krutikdg/GestureCar/BOM.csv

Component | Quantity | Price/Unit (USD) | Purpose | Purchase Link
ESP32 dev board, 38 pin | 2 | 3.65 | car and handheld brain | https://www.electropi.in/esp32-development-board-with-wifi-bluetooth-india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
Ai thinker BU03 kit UWB board | 4 | 34.90 | 3 car anchors and 1 handheld tag for follow me | https://robosap.in/product/ai-thinker-bu03-kit-development-board-uwb-module/
USB cables | 1 | 6.40 | flashing configuring and charging | https://www.flipkart.com/portronics-usb-type-c-cable-3-1-m-konnect-b/p/itm520c0fac46ed5?pid=ACCGKZNAK7DUYE7Z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
header pins | 1 | 0.31 | mounting boards and modules | https://probots.co.in/40-x-1-male-header-pins-long.html
geared DC motor 6V TT style | 4 | 5.60 | wheel drive for the 4WD car | https://robu.in/product/n20-6v-65rpm-metal-gear-motor-with-encoder-d-type/
wheel 65mm | 4 | 1.70 | drive wheels | https://robu.in/product/65mm-robot-smart-car-12-rim-wheel-silver/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
TB6612FNG dual motor driver module | 2 | 1.70 | one driver per side | https://www.flyrobo.in/tb6612fng-dual-motor-driver-module-1a-for-arduino-micro-controller?tracking=ads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
VL53L1X ToF distance sensor module | 1 | 6.20 | front obstacle sensing and auto brake | https://robu.in/product/gy-53-vl53l0x-laser-tof-flight-time-ranging-sensor-module-serial-port-pwm-output/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
HC SR04 ultrasonic sensor | 1 | 2.0 | rear obstacle sensing while reversing | https://www.amazon.in/Robocraze-Ultrasonic-Non-Contact-Resolution-Automation/dp/B01I1ZTPJC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
WS2812B LED strip 5V | 1 | 2.70 | underglow. about 10 pixels fit the plate recess, so a 60 LEDs per metre strip cut to 17 cm is enough | https://www.amazon.in/InLightss-Ws2812b-Flexible-Individual-Addressable/dp/B0CXVKBRM8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
74AHCT125 level shifter IC | 1 | 26.15 | clean 5V data signal for the LED strip from a 3.3V pin | https://www.amazon.in/TQDLYKHS-SN74AHCT125N-MM74ACT125N-MC74ACT125N-MC74ACT125NG/dp/B0CKV2Q71Z
18650 Li-ion cell | 2 | 0.50 | car battery | https://quartzcomponents.com/products/18650-li-ion-rechargeable-battery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
2S 18650 battery holder | 1 | 1 | holds the two car cells | https://www.amazon.in/Electro-Electron-18650-Battery-Holder/dp/B0GJ61WB5H
2S BMS board with balancing | 1 | 1 | car battery protection and balancing | https://www.flyrobo.in/2s-10a-8.4v-li-ion-battery-protection-board-with-balance?tracking=ads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
2S 18650 charger | 1 | 1.55 | Charges the car cells. | https://techdelivers.com/18650-dual-battery-fast-charger-5volt-1amp
Buck converter 6V motor rail | 1 | 2.50 | Regulated motor supply | https://robu.in/product/dc-dc-5-40v-to-6v-1a-buck-converter-module/
Buck converter 5V logic rail 5A | 1 | 1.25 | separate supply for the ESP32 3 UWB anchors sensors and LED strip | https://robocraze.com/products/5a-dc-to-dc-cc-cv-lithium-battery-step-down-charging-board-led-power-converter-lithium-charger-step-down-module-xl4015-red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
Rocker switch 21 x 15 mm rated for motor current | 1 | 0.25 | car power on/off | https://roboticsdna.in/product/black-rocker-switch-on-off-on-3-pin-21x15mm-dpdt-kcd1-6a-250vac-10a-125vac/
inline fuse holder and 5A fuse | 1 | 1.65 | protects the car battery line from shorts | https://www.amazon.in/Ovicart-6-35x25mm-Fuse-5A-Glass/dp/B09YHLYWBZ
electrolytic capacitor 1000 uF 16V | 2 | 0.087 | motor rail and LED strip smoothing | https://www.ktron.in/product/16v-1000uf-electrolytic-capacitor-keltron/
ceramic capacitor 100 nF | 1 | 2.45 | across motor terminals to reduce noise and the handheld battery divider | https://kitsguru.com/products/100nf-50v-monolithic-ceramic-capacitor-104-100pcs
JST connector set | 1 | 2.07 | battery and rail connections | https://www.amazon.in/Electronic-Spices-Connection-Installation-Electronics/dp/B07NBV19QQ
screw terminal blocks (pack) | 1 | 0.90 | motor and power wiring | https://zbotic.in/product/4-pin-2-54mm-pitch-pluggable-screw-terminal-block-pack-of-3/
MPU6050 IMU module | 1 | 2 | handheld tilt sensing | https://techdelivers.com/mpu-6050-gy-521-6-axis-accelerometer-gyroscope-module-i2c-interface-motion-tracking-arduino-compatible-robotics-sensor-embedded-system
SSD1306 0.96 inch OLED I2C | 1 | 1.78 | handheld status display | https://robocraze.com/products/0-96in-oled-display-module-4pin?variant=40192586645657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
tactile push buttons 6 x 6 mm (pack) | 1 | 2 | arm and mode buttons | https://www.amazon.in/ElectroBot-Momentary-Tactile-Push-Button/dp/B07PRRRBRY
RGB LED 5mm common cathode | 1 | 0.45 | handheld status LED | https://robocraze.com/products/5mm-common-anode-rgb-led-4pin-pack-of-10?variant=45740181946592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
coin vibration motor 3V 10 mm | 1 | 0.85 | haptic feedback | https://robu.in/product/erm-coin-vibration-motor-d10mm-w-3-4mm/
NPN transistor BC547 (pack) | 1 | 0.15 | switches the vibration motor | https://robocraze.com/products/bc547-transistor-ic-pack-of-5?variant=40192360448153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
diode 1N4148 (pack) | 1 | 0.40 | flyback protection for the vibration motor | https://robocraze.com/products/1n4148-diode-pack-of-10?variant=40194274263193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
1S LiPo pouch cell 703450 class (about 7 x 34 x 50 mm) 1500 to 1800 mAh with protection board and JST-PH 2.0 plug | 1 | 49 | Handheld battery. Check the plug polarity with a multimeter before connecting | https://www.amazon.in/EEMB-Rechargeable-Connector-Wireless-Polarity/dp/B09DPL8RZH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
TP4056 charging module with protection | 1 | 0.60 | charges the handheld battery | https://electroglobal.in/store/tp4056-charging-module-battery-protection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
5V boost converter module 1S input 2A or more | 1 | 1.30 | steps the handheld battery up to 5V for the ESP32 and BU03 tag | https://robu.in/product/ip5310-5v-3a-type-c-boost-power-module/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
slide switch about 8 x 4 x 4 mm | 1 | 0.35 | handheld power on/off | https://shokitech.com/product/spdt-slide-switch-pack-of-5-for-electronic-projects/
resistor assortment | 1 | 2.40 | dividers LED resistors transistor base and the HC SR04 echo divider | amazon.in/JukrTM-Assorted-Carbon-Resistors-Package/dp/B081LJTFW5
perf board about 70 x 50 mm for the car and a small one for the handheld | 2 | 0.45 | one for the car and one for the handheld | https://rajivelectronics.com/product/70-x-50-mm-double-side-2-54-mm-pitch-general-purpose-dotted-pcb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
silicone hookup wire | 1 | 0.30 | general wiring | https://robu.in/product/high-quality-ultra-flexible-22awg-silicone-wire-1000m-black/
heat shrink tubing assortment | 1 | 1.75 | insulating joints | https://www.amazon.in/Rpi-shop-Polyolefin-Insulated-Multicolour/dp/B08S3TP2Q6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
double sided foam tape and cable ties | 1 | 0.40 | holds the LiPo vibration motor and loose wiring | https://www.zepto.com/pn/thyone-ty-tp23-1pcs-double-sided-foam-tape-3-meter-length-24-mm-width/pvid/954c6ee8-4868-46e8-a52e-0dd70d01cc2a
M3 screws nuts and standoffs kit | 1 | 15.16 | chassis and deck mounting | amazon.in/350PCS-M3-Female-Standoff-Assortment/dp/B0BXT71WJK?source=ps-sl-shoppingads-lpcontext&ref_=fplfs&psc=1&smid=A1YZ9MMK17G6RH
M3 heat set inserts and M3 screws 8 to 10 mm | 1 | 1.10 | six deck posts on the car chassis | https://robu.in/product/m3-x-8-mm-brass-heat-set-threaded-round-insert-nut-25-pcs/
PLA filament 1 kg | 1 | 13.90 | chassis deck and handheld enclosure printing | https://ideal3d.in/products/esun-pla-filament-white
