krutikdg/GestureCar/CAD/car/GestureCar_Chassis_BODY.step

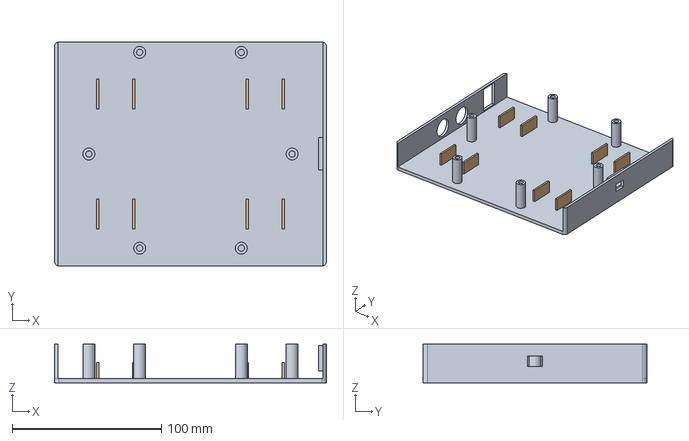
[picture p1: CAD file, 2026-11-11]
CAD/car/GestureCar_Chassis_BODY.step
182.0 x 150.0 x 26.0 mm
