krutikdg/GestureCar/CAD/handheld/GestureCar_Handheld.step

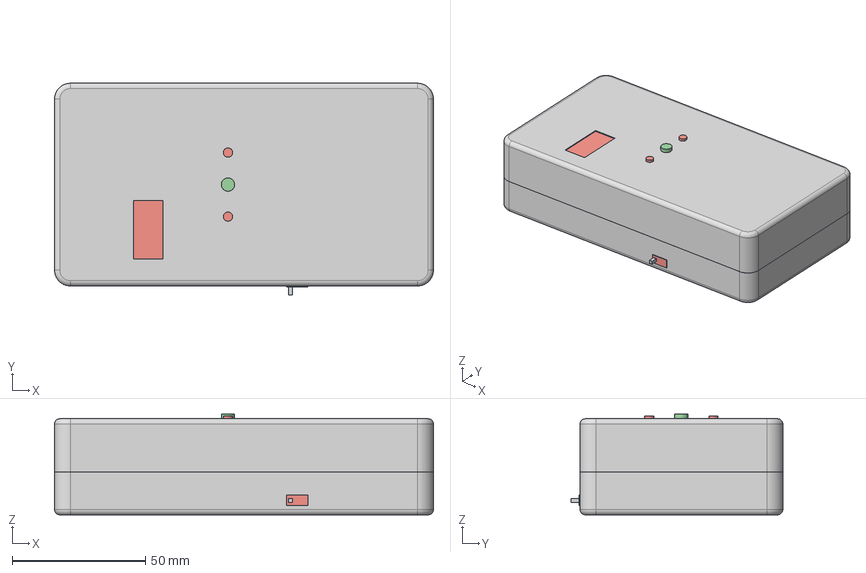
[picture p2: CAD file, 2026-11-11]
CAD/handheld/GestureCar_Handheld.step
142.0 x 79.3 x 37.7 mm
