krutikdg/GestureCar/CAD/car/GestureCar_Chassis.step

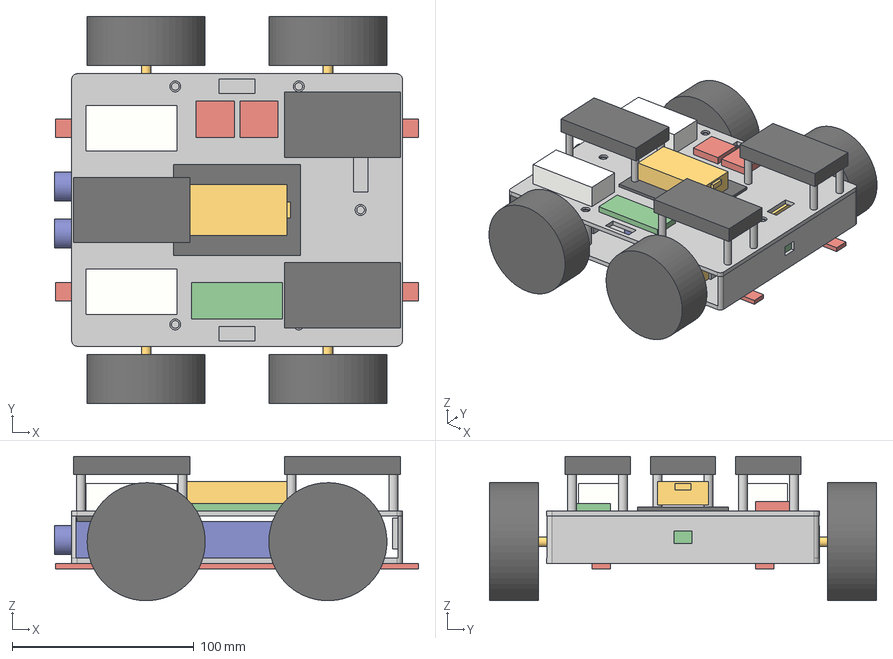
[picture p3: CAD file, 2026-11-11]
CAD/car/GestureCar_Chassis.step
200.6 x 213.0 x 79.5 mm
