krutikdg/GestureCar/CAD/handheld/GestureCar_Handheld_COVER.step

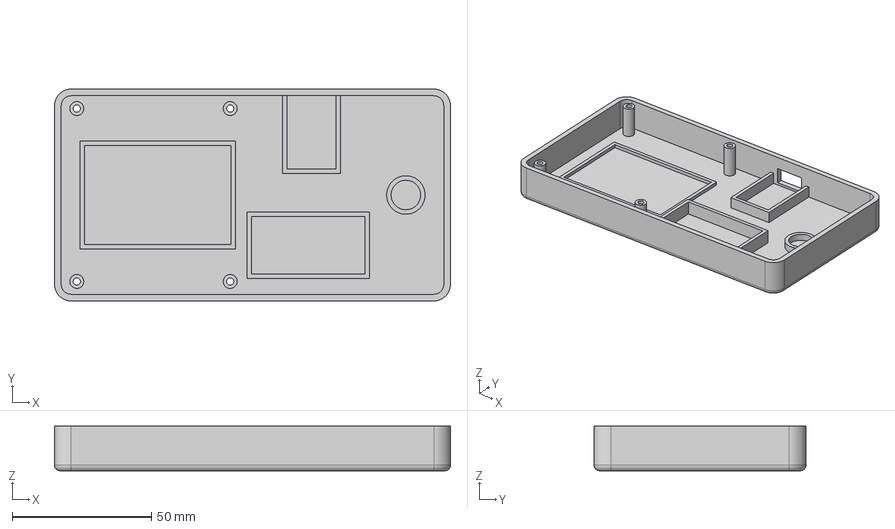
[picture p4: CAD file, 2026-11-11]
CAD/handheld/GestureCar_Handheld_COVER.step
142.0 x 76.0 x 16.0 mm
