krutikdg/GestureCar/CAD/car/GestureCar_Chassis_DECK.step

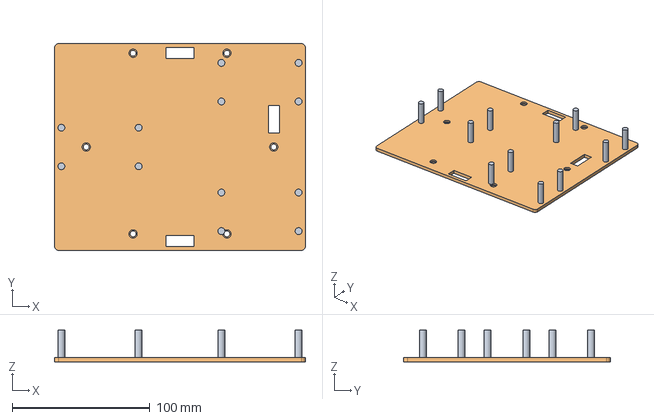
[picture p5: CAD file, 2026-11-11]
CAD/car/GestureCar_Chassis_DECK.step
182.0 x 150.0 x 23.0 mm
