krutikdg/GestureCar/CAD/handheld/GestureCar_Handheld_SHELL.step

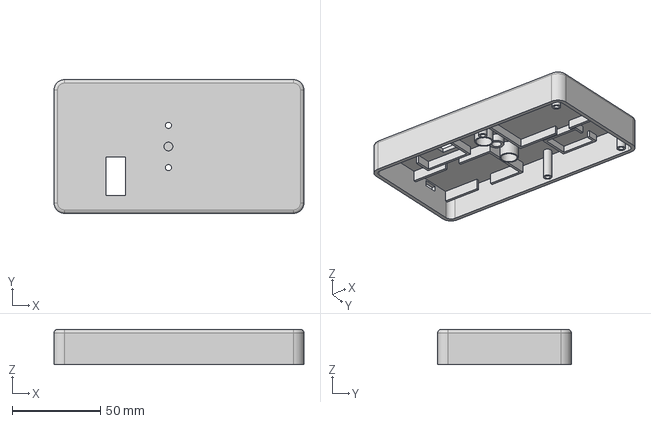
[picture p6: CAD file, 2026-11-11]
CAD/handheld/GestureCar_Handheld_SHELL.step
142.0 x 76.0 x 20.0 mm
