krutikdg/GestureCar/(list of files, cad)

Other CAD files:
CAD/car/GestureCar_Chassis.f3d
CAD/car/GestureCar_Chassis_BODY.f3d
CAD/car/GestureCar_Chassis_BODY.stl
CAD/car/GestureCar_Chassis_DECK.f3d
CAD/car/GestureCar_Chassis_DECK.stl
CAD/handheld/GestureCar_Handheld.f3d
CAD/handheld/GestureCar_Handheld_COVER.f3d
CAD/handheld/GestureCar_Handheld_COVER.stl
CAD/handheld/GestureCar_Handheld_SHELL.f3d
CAD/handheld/GestureCar_Handheld_SHELL.stl
