krutikdg/GestureCar/(commit log)

2026-11-11 added code and cad models
    [GestureCar_Chassis.f3d, GestureCar_Chassis.step, GestureCar_Chassis_BODY.f3d, GestureCar_Chassis_BODY.step, GestureCar_Chassis_BODY.stl, GestureCar_Chassis_DECK.f3d, GestureCar_Chassis_DECK.step, GestureCar_Chassis_DECK.stl]
2026-11-11 Added BOM.csv
    [BOM.csv]
2026-11-11 added BOM to readme
2026-11-11 added pin Map to README
2026-11-12 Update README with CAD diagrams and images
    Added CAD diagrams and images for handheld and car components.
